forGGe/HappySnail-THSensor/README.rst

############################################################################
Happy Snail TH-Sensor: RS-485 ModBus Digital Temperature and Humidity Sensor
############################################################################
