forGGe/HappySnail-THSensor/proto_II/proto_II_kicad/common/3d/Tactile_Switch_5x5mm.STEP

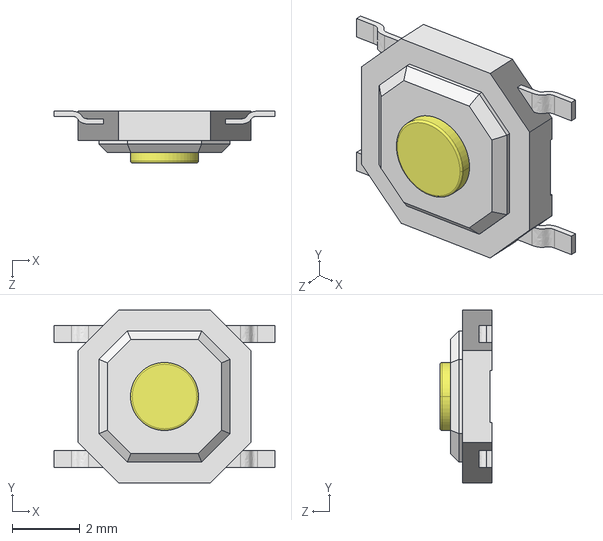
[picture p1: CAD file, 2019-10-02]
proto_II/proto_II_kicad/common/3d/Tactile_Switch_5x5mm.STEP
6.50 x 5.08 x 1.52 mm
