forGGe/HappySnail-THSensor/proto_II/proto_II_kicad/common/3d/Murata_CSTCEXX_3.2mmx1.3mm.stp

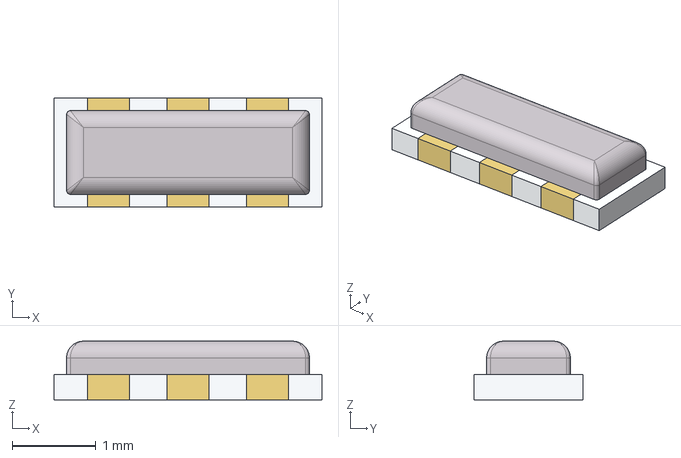
[picture p2: CAD file, 2019-10-02]
proto_II/proto_II_kicad/common/3d/Murata_CSTCEXX_3.2mmx1.3mm.stp
3.20 x 1.30 x 0.7 mm
