forGGe/HappySnail-THSensor/proto_II/proto_II_kicad/common/3d/DG306-5.STEP

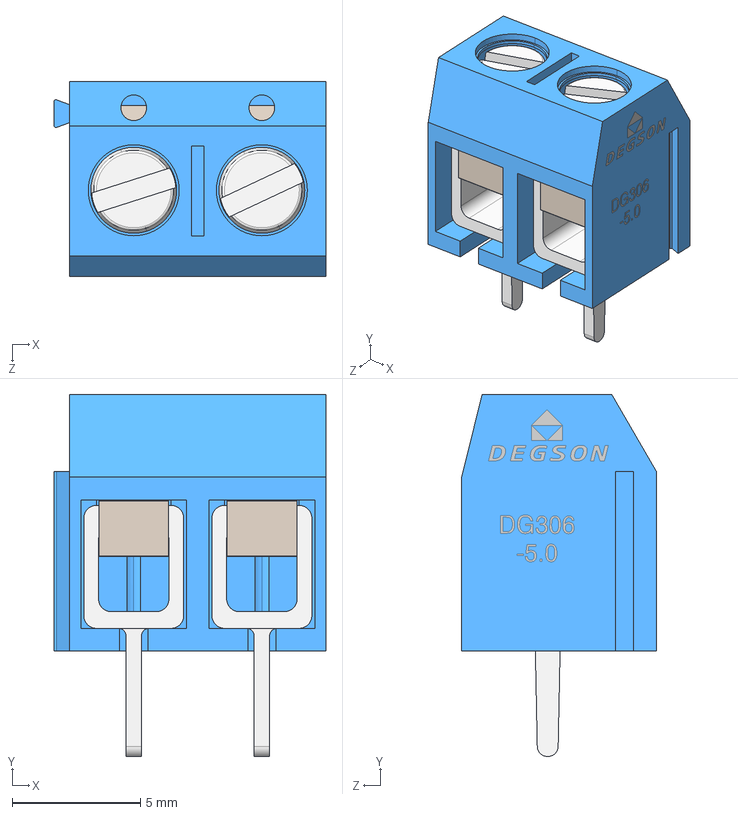
[picture p3: CAD file, 2019-07-09]
proto_II/proto_II_kicad/common/3d/DG306-5.STEP
10.6 x 14.1 x 7.60 mm
Case
Screw x 2
Terminal x 2
Spring x 2
