forGGe/HappySnail-THSensor/proto_II/proto_II_kicad/common/3d/CDRN74.stp

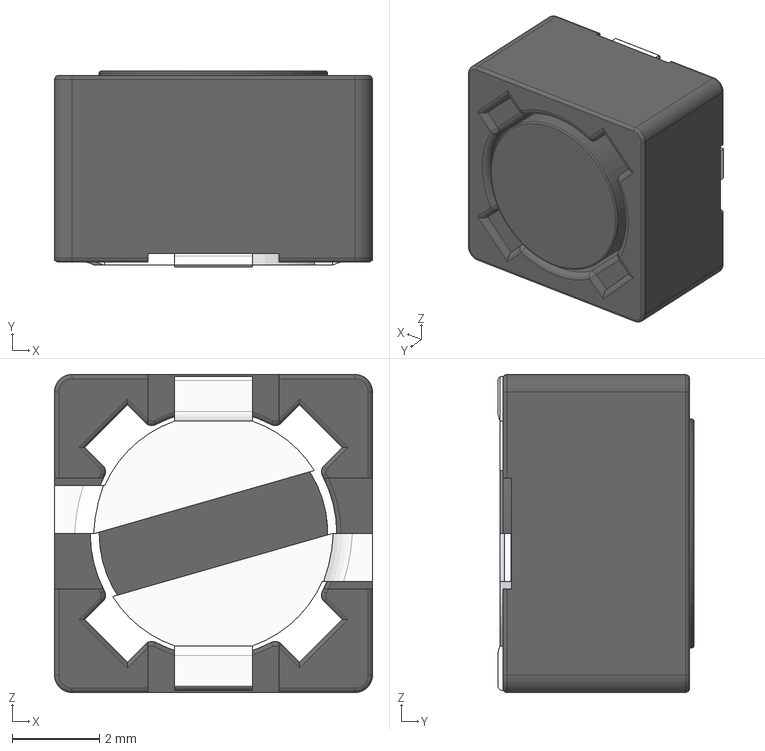
[picture p4: CAD file, 2019-07-09]
proto_II/proto_II_kicad/common/3d/CDRN74.stp
7.30 x 4.50 x 7.30 mm
