forGGe/HappySnail-THSensor/proto_II/proto_II_kicad/common/3d/SF2.STEP

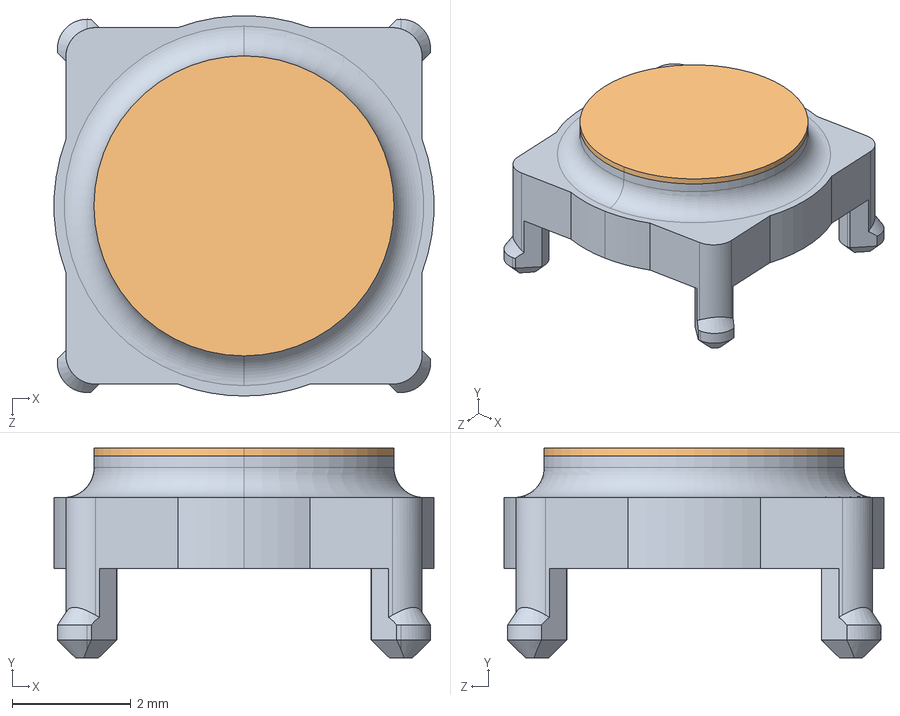
[picture p5: CAD file, 2019-07-07]
proto_II/proto_II_kicad/common/3d/SF2.STEP
6.39 x 3.53 x 6.40 mm
H01-0023_00
H01-0032_00
