forGGe/HappySnail-THSensor/(threads)

Thread 16 (2019-12-26):

Create rev1 for Proto II/Mark I

forGGe, 2019-12-26:
During the testing of Proto II, a number of issues has been found.

Following items must be addressed in rev.1 of the Proto II

- [ ] Check markings near R201 (overlap with via).
- [ ] A and B channels RS485 are swapped (bring it back)
- [ ] Check markings C105
- [ ] R304 and C301 markings should be swapped
- [ ] RX/TX diodes must be reversed, or they should be tied to +3v3 (lid only when in transmit)
- [ ] Reorient doides and resistors to prevent bridges
- [ ] Better way to switch 120 ohm on and off
- [ ] Get rid of 5V-variant network
- [ ] Make test points smaller
- [ ] Add test points for BOOT0/BOOT1, SWDIO/SWCLK/SWGND, DE/~RE
- [ ] Swap UART1 and UART2 - UART1 can be used for flashing a board, better use this as a debug UART
- [ ] No need in two RE/~DE optocouplers - can be used one and split right before ST485
- [ ] Think even further - check ADUMXXX prices with 3 channels instead of 2.
- [ ] Better place connectors, so wires won't overlap with high profile components
- [ ] Use generic components in BOM (0603 LED, etc.) - make sure they match partsbox names
- [ ] Add fiducial
- [ ] Optimize BOM for assembly in jlcpcb

forGGe, 2019-12-26:
> - [x]  Swap UART1 and UART2 - UART1 can be used for flashing a board, better use this as a debug UART

UART2 is not 5V tolerant. Instead, UART3 is used in place of UART1.

So, UART1 will be used for debugging purposes, UART3 will be used for communicating with RS485 transceiver.
