forGGe/HappySnail-THSensor/proto_II/proto_II_kicad/sensor/proto_II_sensor_kicad.kicad_pcb

## KiCad design proto_II/proto_II_kicad/sensor/proto_II_sensor_kicad.kicad_pcb (2019-11-14)

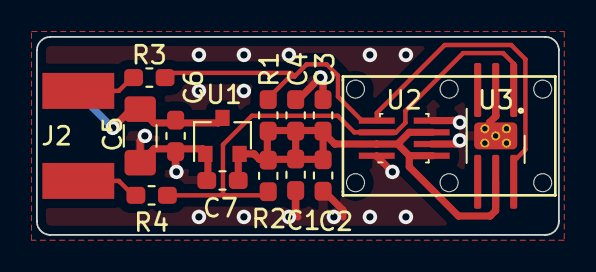
[picture p6: board proto_II_sensor_kicad.kicad_pcb from above]

Board: 2 copper layers, 29.0 x 11.0 mm, 16 parts (1 on the bottom side), 7 nets.

Parts:
C1, C4: 100n; C_0603_1608Metric_Pad1.05x0.95mm_HandSolder
C2, C3: 10n; C_0603_1608Metric_Pad1.05x0.95mm_HandSolder
C5: 10u; C_1206_3216Metric_Pad1.42x1.75mm_HandSolder
C6, C7: 1u; C_0603_1608Metric_Pad1.05x0.95mm_HandSolder
J1, J2: Conn_01x02; PAD_2
R1, R2: 4K7; R_0603_1608Metric_Pad1.05x0.95mm_HandSolder
R3, R4: TERM; R_0603_1608Metric_Pad1.05x0.95mm_HandSolder
U1: XC6206P332MR; SOT-23
U2: BME280; Bosch_LGA-8_2.5x2.5mm_P0.65mm_ClockwisePinNumbering_HandSol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
U3: Si7020-A20; DFN-6-1EP_3x3mm_P1mm_EP1.5x2.4mm_HandSoldering

Connections:
+3V3: C1.1, C2.1, C3.1, C4.1, C7.1, R1.1, R2.1, U1.2, U2.2, U2.6, U2.8, U3.5
+5V: C5.1, C6.1, J1.1, U1.3
/SCL: J2.1, R3.1
/SCL_IC: R1.2, R3.2, U2.4, U3.6
/SDA: J2.2, R4.1
/SDA_IC: R2.2, R4.2, U2.3, U3.1
GND: C1.2, C2.2, C3.2, C4.2, C5.2, C6.2, C7.2, J1.2, U1.1, U2.1, U2.5, U2.7, U3.2, U3.7
