forGGe/HappySnail-THSensor/proto_II/proto_II_kicad/assembly/proto_II_assembly.kicad_pcb

## KiCad design proto_II/proto_II_kicad/assembly/proto_II_assembly.kicad_pcb (2019-11-14)

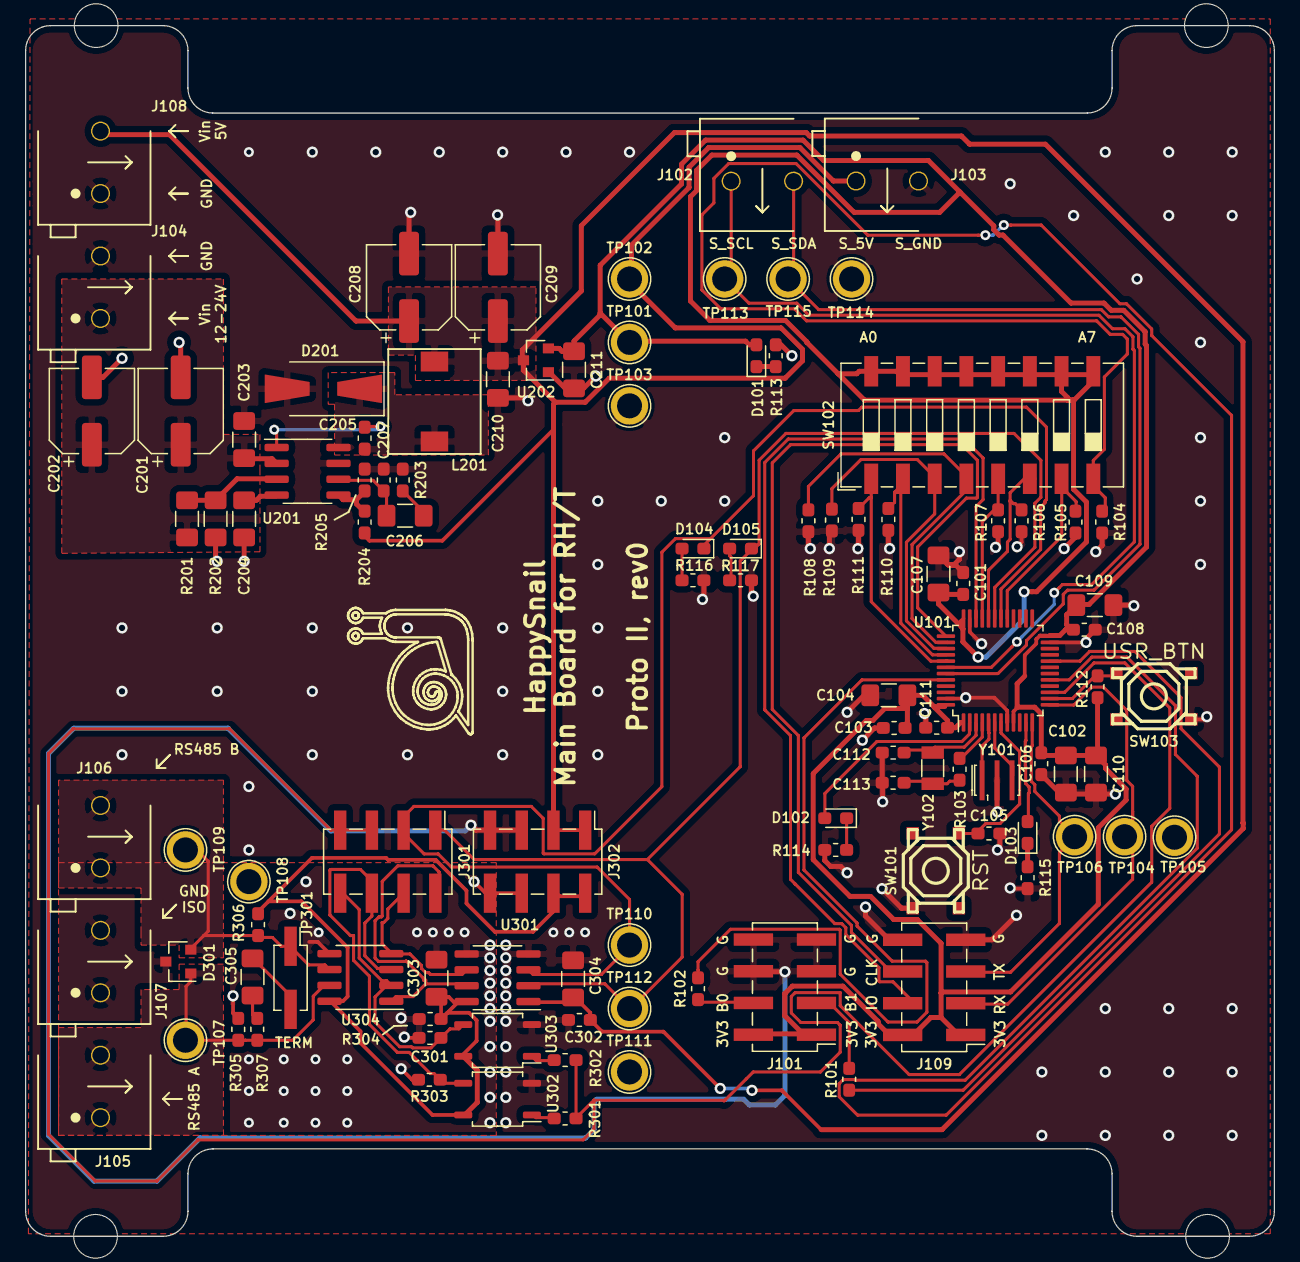
[picture p7: board proto_II_assembly.kicad_pcb from above]

Board: 2 copper layers, 100.0 x 97.0 mm, 105 parts (0 on the bottom side), 58 nets.

Parts:
C101, C103, C105, C106, C108, C111, C205, C301, C302: 100n; C_0603_1608Metric_Pad1.05x0.95mm_HandSolder
C102, C104, C107, C109, C110, C210, C211, C303, C304: 1u; C_1206_3216Metric_Pad1.42x1.75mm_HandSolder
C112, C113, C207: 10p; C_0603_1608Metric_Pad1.05x0.95mm_HandSolder
C201, C202: 10u; CP_Elec_6.3x5.7
C203, C204, C206, C305: 10n; C_1206_3216Metric_Pad1.42x1.75mm_HandSolder
C208, C209: 47u; CP_Elec_6.3x5.7
D101: PWR_LED; D_0603_1608Metric_Pad1.05x0.95mm_HandSolder
D102: USR1_LED; D_0603_1608Metric_Pad1.05x0.95mm_HandSolder
D103: USR2_LED; D_0603_1608Metric_Pad1.05x0.95mm_HandSolder
D104: DI_LED; D_0603_1608Metric_Pad1.05x0.95mm_HandSolder
D105: RO_LED; D_0603_1608Metric_Pad1.05x0.95mm_HandSolder
D201: 700mV; D_SMA-SMB_Universal_Handsoldering
D301: SM712; SOT-23
J101: BOOT_CFG; PinHeader_2x04_P2.54mm_Vertical_SMD
J102: SNSR_I2C; DG300-5.0-02P-12
J103: SNSR_PWR; DG300-5.0-02P-12
J104: Vin; DG300-5.0-02P-12
J105: RS485_A; DG300-5.0-02P-12
J106: RS485_B; DG300-5.0-02P-12
J107: ISO_GND; DG300-5.0-02P-12
J108: Vin-5V; DG300-5.0-02P-12
J109: SWD_DBG; PinHeader_2x04_P2.54mm_Vertical_SMD
J301: SIG_BYPASS; PinHeader_2x04_P2.54mm_Vertical_SMD
J302: PWR_BYPASS; PinHeader_2x04_P2.54mm_Vertical_SMD
JP301: JP; PinHeader_2x01_P2.54mm_Vertical_SMD
L201: 22u; CDRH74
R101, R102, R104, R105, R106, R107, R108, R109, R110, R111, R112, R203, R204, R303, R304: 10K; R_0603_1608Metric_Pad1.05x0.95mm_HandSolder
R103: 0R; R_0603_1608Metric_Pad1.05x0.95mm_HandSolder
R113, R114, R115, R116, R117, R205, R301, R302, R305, R306: 2K2; R_0603_1608Metric_Pad1.05x0.95mm_HandSolder
R201: 220K; R_1206_3216Metric_Pad1.42x1.75mm_HandSolder
R202: 47K; R_1206_3216Metric_Pad1.42x1.75mm_HandSolder
R307: 120; R_0603_1608Metric_Pad1.05x0.95mm_HandSolder
SW101: RST; Tactile_Switch_5x5mm
SW102: MODBUS_ADDR; SW_DIP_SPSTx08_Slide_9.78x22.5mm_W8.61mm_P2.54mm
SW103: USR_BTN; Tactile_Switch_5x5mm
TP101: 3V3; TestPoint_Plated_Hole_D2.0mm
TP102: 5V; TestPoint_Plated_Hole_D2.0mm
TP103: G; TestPoint_Plated_Hole_D2.0mm
TP104: U2_RX; TestPoint_Plated_Hole_D2.0mm
TP105: G_U2; TestPoint_Plated_Hole_D2.0mm
TP106: U2_TX; TestPoint_Plated_Hole_D2.0mm
TP107: A; TestPoint_Plated_Hole_D2.0mm
TP108: G_ISO; TestPoint_Plated_Hole_D2.0mm
TP109: B; TestPoint_Plated_Hole_D2.0mm
TP110: U1_RX; TestPoint_Plated_Hole_D2.0mm
TP111: G_U1; TestPoint_Plated_Hole_D2.0mm
TP112: U1_TX; TestPoint_Plated_Hole_D2.0mm
TP113: SCL; TestPoint_Plated_Hole_D2.0mm
TP114: G_I2C; TestPoint_Plated_Hole_D2.0mm
TP115: SDA; TestPoint_Plated_Hole_D2.0mm
U101: STM32F103C8Tx; LQFP-48_7x7mm_P0.5mm
U201: TPS54331; SOIC-8_3.9x4.9mm_P1.27mm
U202: XC6206P332MR; SOT-23
U301: ADUM5241; SOIC-8_3.9x4.9mm_P1.27mm
U302, U303: EL357N-G; SOP-4_3.8x4.1mm_P2.54mm
U304: ST485EBDR; SOIC-8_3.9x4.9mm_P1.27mm
Y101: HSE; Murata_CSTCE8M0V53-R0-3Pin_3.2x1.1mm_HandSoldering
Y102: LSE; Crystal_SMD_3215-2Pin_3.2x1.5mm

Connections:
+3V3: C101.1, C102.1, C103.1, C104.1, C106.1, C107.1, C108.1, C109.1, C110.1, C111.1, C211.1, D101.2, J101.1, J101.2, J109.1, J109.2, R112.2, SW102.9, SW102.10, SW102.11, SW102.12, SW102.13, SW102.14, SW102.15, SW102.16, TP101.1, U101.1, U101.9, U101.24, U101.36, U101.48, U202.2
+5V: C208.1, C209.1, C210.1, C302.1, C304.1, J103.1, J108.2, J302.1, J302.3, L201.2, R204.1, TP102.1, U202.3, U301.1
+5VD: C301.1, C303.1, J302.2, J302.4, R306.2, U301.8, U302.4, U303.4, U304.8
/BOOT0: R102.2, U101.44
/BOOT1: R101.1, U101.20
/DE~RE: J301.5, J301.7, R301.2, R302.2, U101.15
/I2C1_SCL: J102.1, TP113.1, U101.42
/I2C1_SDA: J102.2, TP115.1, U101.43
/MODBUS_A0: R111.1, SW102.1, U101.41
/MODBUS_A1: R110.1, SW102.2, U101.40
/MODBUS_A2: R109.1, SW102.3, U101.39
/MODBUS_A3: R108.1, SW102.4, U101.38
/MODBUS_A4: R107.1, SW102.5, U101.33
/MODBUS_A5: R106.1, SW102.6, U101.32
/MODBUS_A6: R105.1, SW102.7, U101.29
/MODBUS_A7: R104.1, SW102.8, U101.17
/NRST: C105.1, SW101.2, U101.7
/OSC32_IN: C112.1, U101.3, Y102.1
/OSC32_OUT: R103.1, U101.4
/OSC_IN: U101.5, Y101.1
/OSC_OUT: U101.6, Y101.3
/RS485_A: D301.1, J105.1, J105.2, R305.2, R307.2, TP107.1, U304.7
/RS485_B: D301.2, J106.1, J106.2, JP301.1, R306.1, TP109.1, U304.6
/SWDCLK: J109.6, U101.37
/SWDIO: J109.4, U101.34
/UART1_RX: D105.1, J301.1, TP112.1, U101.31, U301.2
/UART1_TX: D104.1, J301.3, TP110.1, U101.30, U301.3
/UART2_RX: J109.3, TP104.1, U101.13
/UART2_TX: J109.5, TP106.1, U101.12
/USR1_LED: D102.2, U101.2
/USR2_LED: D103.2, U101.11
/USR_BTN: R112.1, SW103.2, U101.14
/power/PH: C205.1, D201.1, L201.1, U201.8
/power/Vin: C201.1, C202.1, C203.1, J104.1, R201.1, U201.2
/rs485/DE_XMTR: J301.6, R303.2, U302.3, U304.3
/rs485/DI_XMTR: J301.4, U301.6, U304.4
/rs485/RE_XMTR: J301.8, R304.2, U303.3, U304.2
/rs485/RO_XMTR: J301.2, U301.7, U304.1
GND: C101.2, C102.2, C103.2, C104.2, C105.2, C106.2, C107.2, C108.2, C109.2, C110.2, C111.2, C112.2, C113.1, C201.2, C202.2, C203.2, C204.2, C207.2, C208.2, C209.2, C210.2, C211.2, C302.2, C304.2, D201.2, J101.5, J101.6, J101.7, J101.8, J103.2, J104.2, J108.1, J109.7, J109.8, J302.5, J302.7, R104.2, R105.2, R106.2, R107.2, R108.2, R109.2, R110.2, R111.2, R113.2, R114.2, R115.2, R116.2, R117.2, R202.2, R203.2, R205.2, SW101.1, SW103.1, TP103.1, TP105.1, TP111.1, TP114.1, U101.8, U101.23, U101.35, U101.47, U201.7, U202.1, U301.4, U302.2, U303.2, Y101.2
GNDD: C301.2, C303.2, D301.3, J107.1, J107.2, J302.6, J302.8, R303.1, R304.1, R305.1, TP108.1, U301.5, U304.5
unnamed: C113.2, R103.2, Y102.2
unnamed: C204.1, U201.4
unnamed: C205.2, U201.1
unnamed: C206.1, C207.1, U201.6
unnamed: C206.2, R203.1
unnamed: C305.1, R307.1
unnamed: C305.2, JP301.2
unnamed: D101.1, R113.1
unnamed: D102.1, R114.1
unnamed: D103.1, R115.1
unnamed: D104.2, R116.1
unnamed: D105.2, R117.1
unnamed: J101.3, R101.2
unnamed: J101.4, R102.1
unnamed: R201.2, R202.1, U201.3
unnamed: R204.2, R205.1, U201.5
unnamed: R301.1, U302.1
unnamed: R302.1, U303.1
