forGGe/HappySnail-THSensor/proto_II/proto_II_kicad/sensor_small/proto_II_sensor_small_kicad.kicad_pcb

## KiCad design proto_II/proto_II_kicad/sensor_small/proto_II_sensor_small_kicad.kicad_pcb (2019-09-16)

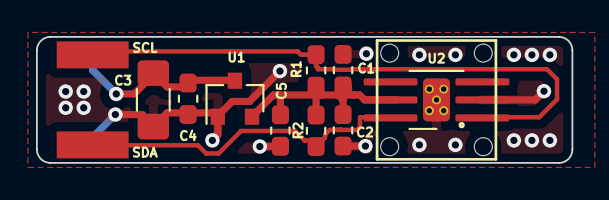
[picture p8: board proto_II_sensor_small_kicad.kicad_pcb from above]

Board: 2 copper layers, 29.8 x 7.0 mm, 11 parts (1 on the bottom side), 5 nets.

Parts:
C1: 100n; C_0603_1608Metric_Pad1.05x0.95mm_HandSolder
C2: 10n; C_0603_1608Metric_Pad1.05x0.95mm_HandSolder
C3: 10u; C_1206_3216Metric_Pad1.42x1.75mm_HandSolder
C4, C5: 1u; C_0603_1608Metric_Pad1.05x0.95mm_HandSolder
J1: PWR_CONN; PAD_2_small
J2: I2C_CONN; PAD_2_small
R1, R2: 4K7; R_0603_1608Metric_Pad1.05x0.95mm_HandSolder
U1: XC6206P332MR; SOT-23
U2: Si7020-A20; DFN-6-1EP_3x3mm_P1mm_EP1.5x2.4mm_HandSoldering

Connections:
+3V3: C1.1, C2.1, C5.1, R1.1, R2.1, U1.2, U2.5
+5V: C3.1, C4.1, J1.1, U1.3
/SCL: J2.1, R1.2, U2.1
/SDA: J2.2, R2.2, U2.6
GND: C1.2, C2.2, C3.2, C4.2, C5.2, J1.2, U1.1, U2.2, U2.7
