forGGe/HappySnail-THSensor/proto_II/proto_II_kicad/buck/proto_II_buck_kicad.kicad_pcb

## KiCad design proto_II/proto_II_kicad/buck/proto_II_buck_kicad.kicad_pcb (2019-08-08)

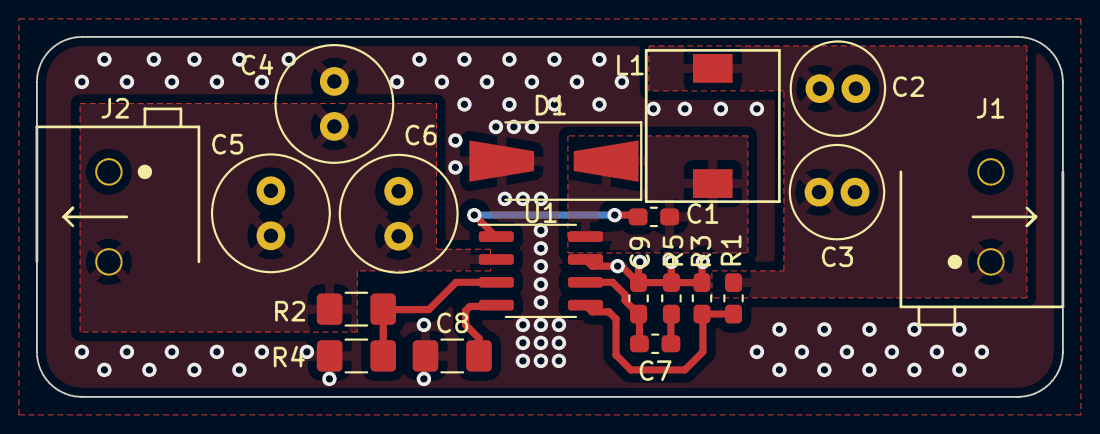
[picture p9: board proto_II_buck_kicad.kicad_pcb from above]

Board: 2 copper layers, 57.0 x 20.0 mm, 19 parts (0 on the bottom side), 10 nets.

Parts:
C1: 100n; C_0603_1608Metric_Pad1.05x0.95mm_HandSolder
C2, C3: 47u; C_Radial_D5.0mm_H11.0mm_P2.00mm
C4, C5: 10u; C_Radial_D6.3mm_H11.0mm_P2.50mm
C6: 10n; C_Radial_D6.3mm_H11.0mm_P2.50mm
C7: 2n2; C_0603_1608Metric_Pad1.05x0.95mm_HandSolder
C8: 10n; C_1206_3216Metric_Pad1.42x1.75mm_HandSolder
C9: 10p; C_0603_1608Metric_Pad1.05x0.95mm_HandSolder
D1: 700mV; D_SMA-SMB_Universal_Handsoldering
J1: VDC_OUT; DG300-5.0-02P-12
J2: VDC_IN; DG300-5.0-02P-12
L1: 22u; CDRH74
R1: 10K; R_0603_1608Metric_Pad1.05x0.95mm_HandSolder
R2: 220K; R_1206_3216Metric_Pad1.42x1.75mm_HandSolder
R3: 2K2; R_0603_1608Metric_Pad1.05x0.95mm_HandSolder
R4: 47K; R_1206_3216Metric_Pad1.42x1.75mm_HandSolder
R5: 13K3; R_0603_1608Metric_Pad1.05x0.95mm_HandSolder
U1: TPS54331; SOIC-8_3.9x4.9mm_P1.27mm

Connections:
/PH: C1.1, D1.1, L1.1, U1.8
/VIN: C4.1, C5.1, C6.1, J2.2, R2.1, U1.2
/VOUT: C2.1, C3.1, J1.1, L1.2, R1.1
GND: C2.2, C3.2, C4.2, C5.2, C6.2, C8.2, C9.2, D1.2, J1.2, J2.1, R3.2, R4.2, R5.2, U1.7
unnamed: C1.2, U1.1
unnamed: C7.1, C9.1, U1.6
unnamed: C7.2, R5.1
unnamed: C8.1, U1.4
unnamed: R1.2, R3.1, U1.5
unnamed: R2.2, R4.1, U1.3
