forGGe/HappySnail-THSensor/proto_II/proto_II_kicad/rs485/proto_II_rs485.kicad_pcb

## KiCad design proto_II/proto_II_kicad/rs485/proto_II_rs485.kicad_pcb (2019-07-18)

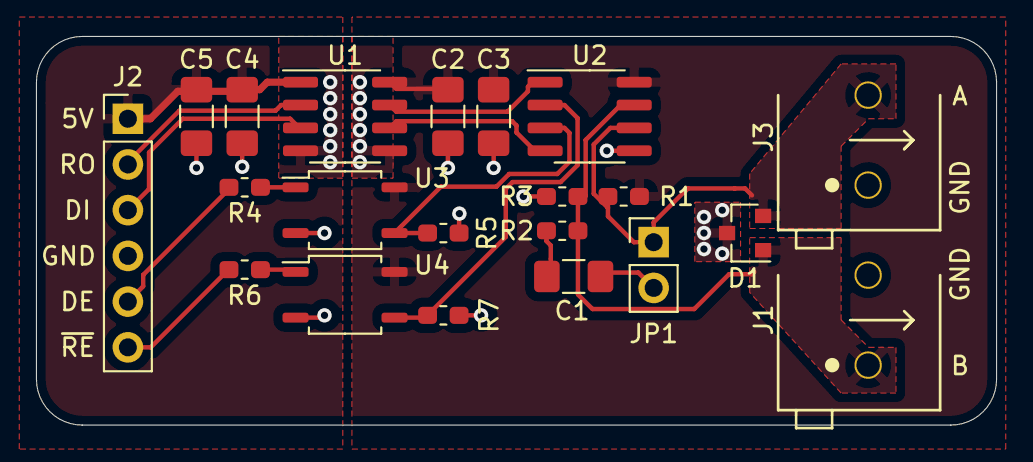
[picture p10: board proto_II_rs485.kicad_pcb from above]

Board: 2 copper layers, 53.3 x 21.6 mm, 21 parts (0 on the bottom side), 18 nets.

Parts:
C1: 10n; C_1206_3216Metric_Pad1.42x1.75mm_HandSolder
C2, C4: 100n; C_1206_3216Metric_Pad1.42x1.75mm_HandSolder
C3, C5: 1u; C_1206_3216Metric_Pad1.42x1.75mm_HandSolder
D1: SM712; SOT-23
J1: A_CONN; DG300-5.0-02P-12
J2: INPUT; PinHeader_1x06_P2.54mm_Vertical
J3: B_CONN; DG300-5.0-02P-12
JP1: JP; PinHeader_1x02_P2.54mm_Vertical
R1, R3, R4, R6: 2K2; R_0603_1608Metric_Pad1.05x0.95mm_HandSolder
R2: 120; R_0603_1608Metric_Pad1.05x0.95mm_HandSolder
R5, R7: 10K; R_0603_1608Metric_Pad1.05x0.95mm_HandSolder
U1: ADUM5241; SOIC-8_3.9x4.9mm_P1.27mm
U2: ST485EBDR; SOIC-8_3.9x4.9mm_P1.27mm
U3, U4: EL357N-G; SOP-4_3.8x4.1mm_P2.54mm

Connections:
+5V: C4.1, C5.1, J2.1, U1.1
+5VD: C2.1, C3.1, R1.2, U1.8, U2.8, U3.4, U4.4
/A: D1.2, J3.2, JP1.1, R1.1, U2.6
/B: D1.1, J1.1, R2.2, R3.2, U2.7
/DE: J2.5, R4.2
/DI: J2.3, U1.3
/RO: J2.2, U1.2
/~RE: J2.6, R6.2
GND: C4.2, C5.2, J2.4, U1.4, U3.2, U4.2
GNDD: C2.2, C3.2, D1.3, J1.2, J3.1, R3.1, R5.1, R7.1, U1.5, U2.5
unnamed: C1.1, R2.1
unnamed: C1.2, JP1.2
unnamed: R4.1, U3.1
unnamed: R5.2, U2.3, U3.3
unnamed: R6.1, U4.1
unnamed: R7.2, U2.2, U4.3
unnamed: U1.6, U2.4
unnamed: U1.7, U2.1
