forGGe/HappySnail-THSensor/proto_II/proto_II_zephyr/src/main.c

/*
 * Copyright (c) 2012-2014 Wind River Systems, Inc.
 *
 * SPDX-License-Identifier: Apache-2.0
 */

#include <zephyr.h>
#include <device.h>
#include <sensor.h>
#include <stdio.h>
#include <gpio.h>
#include <misc/printk.h>
#include <assert.h>
#include <uart.h>
#include <string.h>
#include <sys/types.h>
#include <stdlib.h>
#include <i2c.h>
#include <logging/log.h>
#include <stm32f1xx_ll_adc.h>
#include <stm32f1xx_ll_rcc.h>
#include <stm32f1xx_ll_bus.h>

#define MODBUS_BAT_SLAVE_ADDRESS 		42

/* Test registers, used in this BAT */
enum modbus_regs
{
	MODBUS_BAT_INPUT_REG_FIRST		= 1000,
	MODBUS_BAT_INPUT_REG_TEMP_HIGH		= MODBUS_BAT_INPUT_REG_FIRST,
	MODBUS_BAT_INPUT_REG_TEMP_LOW,
	MODBUS_BAT_INPUT_REG_HUMID_HIGH,
	MODBUS_BAT_INPUT_REG_HUMID_LOW,
	MODBUS_BAT_INPUT_REG_PRESSURE_HIGH,
	MODBUS_BAT_INPUT_REG_PRESSURE_LOW,
	MODBUS_BAT_INPUT_REG_LAST		= MODBUS_BAT_INPUT_REG_PRESSURE_LOW,
};

/* Test functions, used in this BAT */
enum modbus_fn
{
/* Not supported (yet)
	MODBUS_FN_READ_COIL			= 0x1,
	MODBUS_FN_READ_INPUT_STATUS		= 0x2,
	MODBUS_FN_READ_INPUT_REG		= 0x4,
*/
	MODBUS_FN_READ_HOLDING_REG		= 0x3,
};

enum modbus_states
{
	MODBUS_EMPTY,
	MODBUS_WAIT_CR,
	MODBUS_WAIT_LF,
	MODBUS_COMPLETE,
};

struct modbus_frame
{
	u8_t data[256];
	u8_t cnt;
	enum modbus_states state;
};

struct modbus_data
{
	u8_t addr;
	u8_t fn;
	uint16_t obj_addr;
	uint16_t qty;
	u8_t crc;
	bool complete;
};

static uint32_t hexchunk_toul(const char *start, size_t qty)
{
	char buf[qty + 1];
	memcpy(buf, start, qty);
	buf[qty] = 0;

	return strtol(buf, NULL, 16);
}

/* TODO: ugly */
static u8_t modbus_lrc(const u8_t *data, size_t sz)
{
	u8_t lrc = 0;

	for (size_t i = 0; i < sz; i += 2) {
		lrc += hexchunk_toul(&data[i], 2);
	}

	return (u8_t)(-lrc);
}

static int modbus_process_raw_frame(struct modbus_frame *buf, struct modbus_data *out)
{
	assert(out != NULL);
	assert(buf != NULL);

	if (buf->cnt != 14) {
		printf("frames with length %d are not supported yet\n", buf->cnt);
		return -1;
	}

	u8_t crc;
	u8_t calc_crc;

	/* TODO: better error check */

	out->addr 	= hexchunk_toul(&buf->data[0], 2);
	out->fn 	= hexchunk_toul(&buf->data[2], 2);
	out->obj_addr 	= hexchunk_toul(&buf->data[4], 4);
	out->qty 	= hexchunk_toul(&buf->data[8], 4);
	crc 		= hexchunk_toul(&buf->data[12], 2);

	if (out->addr != 42) {
		printf("not supported slave address %d\n", out->addr);
		return -1;
	}

	if (out->obj_addr != MODBUS_BAT_INPUT_REG_FIRST) {
		printf("reading regs starting from %d is not implemented\n", out->obj_addr);
		return -1;
	}

	if (out->qty != (MODBUS_BAT_INPUT_REG_LAST - MODBUS_BAT_INPUT_REG_FIRST + 1)) {
		printf("reading regs of range: %d not implmented\n", out->qty);
		return -1;
	}

	/* Exclude crc byte at the end of the packet */
	calc_crc = modbus_lrc(buf->data, buf->cnt - 2);

	if (calc_crc != crc) {
		printf("crc failed. expect: %#x, actual: %#x\n", calc_crc, crc);
	}

	return 0;
}

/**
 * \return Number of bytes processed.
 * \retval 0 Parsing already complete.
 * \retval -1 Invalid frame detected.
 */
static ssize_t modbus_process_raw_data(struct modbus_frame *buf, struct modbus_data *out, const u8_t *new_data, size_t new_data_sz)
{
	assert(buf != NULL);
	assert(out != NULL);
	assert(new_data != NULL);

	printf("buf state: %d %d\n", buf->cnt, buf->state);

	size_t bytes_processed = 0;
	for (; bytes_processed < new_data_sz; ++bytes_processed) {
		u8_t data_byte = new_data[bytes_processed];

		/* Check that buffer is in valid state */
		if (buf->cnt == sizeof(buf->data) - 1) {
			printf("overflow detected\n");
			buf->cnt = 0;
			buf->state = MODBUS_EMPTY;
			continue;
		}

		/* Detect frame start; if detected - should re-init parser at any state */
		if (data_byte == ':') {
			printf("frame start detected\n");
			buf->state = MODBUS_WAIT_CR;
			buf->cnt = 0;
			out->complete = false;
			continue;
		}

		switch (buf->state) {
		case MODBUS_EMPTY:
			printf("skipping data, not yet found a frame start\n");
			break;
		case MODBUS_WAIT_CR:
			/* Check allowed set of symbols */
			if ((data_byte < '0' || data_byte > '9')
					&& (data_byte < 'A' || data_byte > 'F')
					&& data_byte != '\r') {
				printf("invalid symbol detected\n");
				buf->state = MODBUS_EMPTY;
				buf->cnt = 0;
				continue;
			}

			if (data_byte == '\r') {
				printf("CR detected\n");
				buf->state = MODBUS_WAIT_LF;
				continue;
			}

			/* Only state where appending symbols is allowed */
			buf->data[buf->cnt++] = data_byte;
			break;
		case MODBUS_WAIT_LF:
			if (data_byte == '\n') {
				printf("LF detected\n");
				buf->state = MODBUS_COMPLETE;
				printf("data recv: %*s\n", buf->cnt, buf->data);

				if (modbus_process_raw_frame(buf, out) < 0) {
					/* Parsing failed, but invalid and old data can be discarded */
					buf->cnt = 0;
					return -1;
				}

				/* Parsing complete */
				buf->cnt = 0;
				out->complete = true;
				return bytes_processed;
			} else {
				printf("invalid symbol detected while waiting for LF\n");
				buf->state = MODBUS_EMPTY;
				buf->cnt = 0;
			}
			continue;
		case MODBUS_COMPLETE:
			printf("complete frame, no more symbols required\n");
			continue;
			break;
		default:
			printf("invalid state: %d\n", buf->state);
			continue;
			break;
		}
	}

	/* Need more data */
	return bytes_processed;
}

struct drv_ctx
{
	struct device *dev;
	struct device *gpio_dev;
	struct drv_buf {
		u8_t data[256];
		u8_t cnt;
	} buf;
	struct drv_tx_buf {
		u8_t buf[256];
		size_t sz;
		size_t cur;
	} tx_buf;
};

static void uart1_irq_cb(void *user_data)
{
	struct drv_ctx *ctx = user_data;

	uart_irq_update(ctx->dev);

	if (uart_irq_rx_ready(ctx->dev)) {
		int read = uart_fifo_read(ctx->dev, ctx->buf.data + ctx->buf.cnt,
			ARRAY_SIZE(ctx->buf.data) - ctx->buf.cnt);
		ctx->buf.cnt += read;
	}

	/* Check for End-of-TX */
	if (ctx->tx_buf.cur == ctx->tx_buf.sz) {
		ctx->tx_buf.cur = 0;
		ctx->tx_buf.sz = 0;
		uart_irq_tx_disable(ctx->dev);
		/* Enable RS485 RX line and disable TX */
		gpio_pin_write(ctx->gpio_dev, 5, 0);
	}

	if (uart_irq_tx_ready(ctx->dev)
			&& ctx->tx_buf.sz != 0
			&& ctx->tx_buf.cur < ctx->tx_buf.sz) {
		int written = uart_fifo_fill(ctx->dev, &ctx->tx_buf.buf[ctx->tx_buf.cur], 1);
		ctx->tx_buf.cur += written;
	}
}

static struct drv_ctx modbus_ctx;
static struct drv_buf modbus_safe_data;

static int hs_adc_configure(void)
{
	LL_APB2_GRP1_EnableClock(LL_APB2_GRP1_PERIPH_ADC1);
	LL_RCC_SetADCClockSource(LL_RCC_ADC_CLKSRC_PCLK2_DIV_4);

	printf("starting ADC\n");

	LL_ADC_Enable(				ADC1);

	/*
	 * Wait until ADC is completely ready.
	 * TODO: find out precise value of tSTAB for ADC stabilization. See datasheet.
	 */
	k_sleep(100);

	LL_ADC_StartCalibration(		ADC1);
	while (LL_ADC_IsCalibrationOnGoing(	ADC1) == 1) { };

	printf("ADC calibration complete\n");

	/* Enable temperature sensor and voltage ref sampling */
	LL_ADC_SetCommonPathInternalCh(__LL_ADC_COMMON_INSTANCE(ADC1),
			LL_ADC_PATH_INTERNAL_VREFINT | LL_ADC_PATH_INTERNAL_TEMPSENSOR);

	LL_ADC_SetDataAlignment(		ADC1, LL_ADC_DATA_ALIGN_RIGHT);
	LL_ADC_SetSequencersScanMode(		ADC1, LL_ADC_SEQ_SCAN_DISABLE);
	LL_ADC_REG_SetTriggerSource(		ADC1, LL_ADC_REG_TRIG_SOFTWARE);
	LL_ADC_REG_SetSequencerLength(		ADC1, LL_ADC_REG_SEQ_SCAN_DISABLE);
	LL_ADC_REG_SetSequencerDiscont(		ADC1, LL_ADC_REG_SEQ_DISCONT_DISABLE);
	LL_ADC_REG_SetSequencerRanks(		ADC1, LL_ADC_REG_RANK_1, LL_ADC_CHANNEL_TEMPSENSOR);
	LL_ADC_REG_SetContinuousMode(		ADC1, LL_ADC_REG_CONV_SINGLE);
	LL_ADC_REG_SetDMATransfer(		ADC1, LL_ADC_REG_DMA_TRANSFER_NONE);

	/* TODO: tune this value? */
	LL_ADC_SetChannelSamplingTime(		ADC1, LL_ADC_CHANNEL_TEMPSENSOR, LL_ADC_SAMPLINGTIME_239CYCLES_5);

	LL_ADC_SetAnalogWDMonitChannels(	ADC1, LL_ADC_AWD_DISABLE);

	/* Start spare conversion. For some reason, it helps with incorrect MCU temp sensor readings at the beginning */
	LL_ADC_Enable(				ADC1);

	return 0;
}

static int hs_adc_read_mcu_temp(u32_t *mcu_temp)
{
	printf("getting ADC data from internal sensor\n");

	LL_ADC_REG_StartConversionSWStart(ADC1);

	while (LL_ADC_IsActiveFlag_EOS(ADC1) == 0) {
		k_sleep(1000);
	};

	u32_t data = LL_ADC_REG_ReadConversionData12(ADC1);

	/* Temperature sensor voltage at 25C, from datasheet, in mV */
	const u32_t v25 = 1430;
	/* Average slope, from datasheet, uV per C */
	const u32_t avg_slope = 4300;

	/* Temperature sensor readings, in mV. Note Vref = 3300 mV */
	u32_t v_sense = 3300 * data / 4096;

	/*
	 * Final temperature value. Note scaling (V25 - Vsense) from mV to uV
	 * Divident in uV, divisor in uV/C, thus resulting value is in C.
	 */
	u32_t temp = (1000 * (v25 - v_sense) / avg_slope) + 25;

	printf("adc data: %#x, mV: %d, temp: %d\n", data, v_sense, temp);

	*mcu_temp = temp;
	return 0;
}

void main(void)
{
	struct device *sensor_dev = device_get_binding("SENSOR_CHIP");
	struct device *rs485_dev = device_get_binding("UART_1");
	struct device *gpioa = device_get_binding("GPIOA");

	modbus_ctx.dev = rs485_dev;
	modbus_ctx.gpio_dev = gpioa;

	int rc;

	printf("Hello World! %s\n", CONFIG_BOARD);
	printf("Starting BAT test for Happy Snail RH/T subproject\n");

	if (sensor_dev == NULL) {
		printf("could not get SI7006 device\n");
		return;
	}

	if (gpioa == NULL) {
		printf("could not get GPIOA device\n");
		return;
	}

	if (rs485_dev == NULL) {
		printf("could not get RS485 device\n");
		return;
	}

	printf("sensor_dev %p name %s\n", sensor_dev, sensor_dev->config->name);

	/* Enable internal ADC for getting MCU temp */

	rc = hs_adc_configure();
	if (rc < 0) {
		printf("failed to configure ADC");
	}

	/* Enable RS485 and configure UART */

	rc = gpio_pin_configure(gpioa, 5, GPIO_DIR_OUT);
	if (rc < 0) {
		printf("failed to configure GPIO pin\n");
	}

	struct uart_config uart1_cfg = {
		.baudrate	= 9600,
		.parity		= UART_CFG_PARITY_NONE,
		.stop_bits	= UART_CFG_STOP_BITS_1,
		.data_bits	= UART_CFG_DATA_BITS_8,
		.flow_ctrl	= UART_CFG_FLOW_CTRL_NONE
	};

	rc = uart_configure(rs485_dev, &uart1_cfg);
	if (rc < 0) {
		printf("failed to configure uart1: %d\n", rc);
		goto err;
	}

	uart_irq_callback_user_data_set(rs485_dev, uart1_irq_cb, &modbus_ctx);

	uart_irq_rx_enable(rs485_dev);

	struct modbus_frame frame = {0};
	struct modbus_data modbus_parsed = {0};

	/* Enable RS485 RX line and disable TX */
	gpio_pin_write(gpioa, 5, 0);

	while (1) {
		k_cpu_idle();

		irq_disable(DT_USART_1_IRQ);
		memcpy(&modbus_safe_data, &modbus_ctx.buf, sizeof(modbus_safe_data));
		modbus_ctx.buf.cnt = 0;
		irq_enable(DT_USART_1_IRQ);

		if (modbus_safe_data.cnt > 0) {
			printf("> data %d: %*s\n", (int)modbus_safe_data.cnt, modbus_safe_data.cnt, modbus_safe_data.data);
			size_t read = modbus_process_raw_data(&frame, &modbus_parsed, modbus_safe_data.data, modbus_safe_data.cnt);
			printf("> modbus processed: %d\n", read);
			if (modbus_parsed.complete) {
				struct sensor_value temp = {0};
				struct sensor_value humidity = {0};
				u32_t mcu_temp;

				sensor_sample_fetch(sensor_dev);
				sensor_channel_get(sensor_dev, SENSOR_CHAN_AMBIENT_TEMP, &temp);
				sensor_channel_get(sensor_dev, SENSOR_CHAN_HUMIDITY, &humidity);
				hs_adc_read_mcu_temp(&mcu_temp);

				printf("temp: %d.%06d; mcu_temp: %d; humidity: %d.%06d\n",
					temp.val1, temp.val2,
					mcu_temp,
					humidity.val1, humidity.val2);

				bool retry = true;
				do {
					irq_disable(DT_USART_1_IRQ);
					if (modbus_ctx.tx_buf.sz == 0) {
						/* TODO: ugly */
						int n = snprintf(modbus_ctx.tx_buf.buf, sizeof(modbus_ctx.tx_buf.buf),
							":%02X%02X%02X%04X%04X%04X%04X%04X%04X",
							MODBUS_BAT_SLAVE_ADDRESS, MODBUS_FN_READ_HOLDING_REG,
							12, /* Total bytes to be transmitted */
							(s16_t)temp.val1, 	(s16_t)(temp.val2 / 10000), /* Convert 10^-6 fixed-point value to 10^-2 */
							(s16_t)mcu_temp,	(s16_t)(0), /* Convert 10^-6 fixed-point value to 10^-2 */
							(s16_t)humidity.val1,	(s16_t)(humidity.val2 / 10000) /* Convert 10^-6 fixed-point value to 10^-2 */
						);

						/* TODO: ugly */

						u8_t crc = modbus_lrc(modbus_ctx.tx_buf.buf + 1, n - 1);
						n += snprintf(modbus_ctx.tx_buf.buf + n, sizeof(modbus_ctx.tx_buf.buf) - n,
							"%02X\r\n", crc);
						modbus_ctx.tx_buf.sz = n;
						printf("> sending: %*s\n", modbus_ctx.tx_buf.sz, modbus_ctx.tx_buf.buf);
						retry = false;
					}

					irq_enable(DT_USART_1_IRQ);
					k_sleep(100);
				} while (retry);

				/* Enable RX line and disable TX */
				gpio_pin_write(gpioa, 5, 1);

				/* Rest of processing will occur in ISR routine */
				uart_irq_tx_enable(rs485_dev);

				retry = true;
				do {
					irq_disable(DT_USART_1_IRQ);
					retry = (modbus_ctx.tx_buf.sz != 0);
					irq_enable(DT_USART_1_IRQ);
					k_sleep(100);
				} while (retry);

				printf("response sent\n");
				/* Done with sending this response, try next one */
				modbus_parsed.complete = false;
			}

			modbus_safe_data.cnt -= read;
		}
	}

	return;
err:
	printf("failed to run BAT\n");
}
