forGGe/HappySnail-THSensor/proto_I/.attic/common/arduino/modbus/ModbusSerial.h

/*
    ModbusSerial.h - Header for ModbusSerial Library
    Copyright (C) 2014 Andr� Sarmento Barbosa
*/
#include <Arduino.h>
#include "Modbus.h"

#ifndef MODBUSSERIAL_H
#define MODBUSSERIAL_H

//#define USE_SOFTWARE_SERIAL

#ifdef USE_SOFTWARE_SERIAL
#include <SoftwareSerial.h>
#endif

class ModbusSerial : public Modbus {
    private:
        Stream* _port;
        long  _baud;
        u_int _format;
        int   _txPin;
        unsigned int _t15; // inter character time out
        unsigned int _t35; // frame delay
        byte  _slaveId;
        word calcCrc(byte address, byte* pduframe, byte pdulen);
    public:
        ModbusSerial();
        bool setSlaveId(byte slaveId);
        byte getSlaveId();
        bool config(HardwareSerial* port, long baud, u_int format, int txPin=-1);
        #ifdef USE_SOFTWARE_SERIAL
        bool config(SoftwareSerial* port, long baud, int txPin=-1);
        #endif
        #ifdef __AVR_ATmega32U4__
        bool config(Serial_* port, long baud, u_int format, int txPin=-1);
        #endif
        void task();
        bool receive(byte* frame);
        bool sendPDU(byte* pduframe);
        bool send(byte* frame);
};

/* Table of CRC values for high�order byte */
const byte _auchCRCHi[] = {
    0x00, 0xC1, 0x81, 0x40, 0x01, 0xC0, 0x80, 0x41, 0x01, 0xC0, 0x80, 0x41, 0x00, 0xC1, 0x81,
	0x40, 0x01, 0xC0, 0x80, 0x41, 0x00, 0xC1, 0x81, 0x40, 0x00, 0xC1, 0x81, 0x40, 0x01, 0xC0,
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
	0x48, 0x49, 0x89, 0x4B, 0x8B, 0x8A, 0x4A, 0x4E, 0x8E, 0x8F, 0x4F, 0x8D, 0x4D, 0x4C, 0x8C,
	0x44, 0x84, 0x85, 0x45, 0x87, 0x47, 0x46, 0x86, 0x82, 0x42, 0x43, 0x83, 0x41, 0x81, 0x80,
	0x40};

#endif //MODBUSSERIAL_H
