forGGe/HappySnail-THSensor/(commit log)

2019-06-16 Add prototype I subproject tree and basic schematic
    [proto_I_kicad.kicad_pcb, proto_I_kicad.sch]
2019-06-16 RS485 reading and writing
    [proto_I_kicad.sch]
2019-06-19 Zephyr-based BAT placeholder
    Previous stuff moved to .attic
    [proto_I_kicad.sch]
2019-06-23 Complete BAT schematics
    [proto_I_kicad.sch]
2019-06-30 Proto II: basic circuit around TPS54331, not computed yet
    Values of components to be computed later.
    [file5D1E3AAE.sch, proto_II_kicad.kicad_pcb, proto_II_kicad.sch]
2019-07-02 Re-wire switching power supply and add sensor sub-project
    Switching regulator re-wired according to guidelines.
    Still, freq compensation values must be re-calculated.
    Sensor sub-project is added. Its purpose to deliver small PCB
    board, where sensor is soldered and sealed.
    [buck_subpcb.sch, file5D1E3AAE.sch, proto_II_kicad.sch, proto_II_sensor_kicad.sch]
2019-07-07 Proto II: route for sensor board
    Add libraries and footprints for SF2 cap and simple PAD connector for
    soldering wires
    [SF2.STEP, proto_II_kicad.sch, proto_II_sensor_kicad.sch]
2019-07-09 Proto II: route buck converter sub-board
    Additionally:
    - Made footprint for inductor and found 3d-model for that
    - Add missing PCB and netlist for sensor sub-board (see previous commit)
    - Couple of addtions for existing footprints (SF2, PAD, etc.)A
    - Update gitignore to ignore cache KiCAD files
    [CDRN74.stp, DG306-5.STEP, proto_II_buck_kicad.kicad_pcb, proto_II_buck_kicad.sch, proto_II_sensor_kicad.kicad_pcb]
2019-07-09 Proto II: panelized sensor and buck board, order from JLCPCB
    + gerber files
    [buck_subpcb.sch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]
2019-07-12 Proto II: cleanup and move project to separate dirs
    Common library is substituted. Gerber files are updated to match what
    sent to JLCPCB
    [CDRN74.stp, DG306-5.STEP, SF2.STEP, buck_subpcb.sch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]
2019-07-17 Proto II: RS485 isolated module board
    [proto_II_rs485.kicad_pcb, proto_II_rs485.sch]
2019-07-18 Proto II: RS485 isolated module board, order from JLCPCB
    [proto_II_rs485-B_Cu.gbr, proto_II_rs485-B_Mask.gbr, proto_II_rs485-B_Paste.gbr, proto_II_rs485-B_SilkS.gbr, proto_II_rs485-Edge_Cuts.gbr, proto_II_rs485-F_Cu.gbr, proto_II_rs485-F_Mask.gbr, proto_II_rs485-F_Paste.gbr]
2019-08-08 Capture real part information into the schematic
    [proto_II_buck_kicad.kicad_pcb, proto_II_buck_kicad.sch, proto_II_rs485.sch, proto_II_sensor_kicad.kicad_pcb, proto_II_sensor_kicad.sch]
2019-08-16 Rework sensor board: allow hand-soldering of sensor
    Additional sensor is used with easier footprint: Si70XX series
    [proto_II_rs485.sch, proto_II_sensor_kicad.kicad_pcb, proto_II_sensor_kicad.sch]
2019-08-17 Rework sensor board: gerber files
    [proto_II_sensor_kicad-B_Cu.gbl, proto_II_sensor_kicad-B_Mask.gbs, proto_II_sensor_kicad-B_Paste.gbp, proto_II_sensor_kicad-B_SilkS.gbo, proto_II_sensor_kicad-Board.gm1, proto_II_sensor_kicad-Bot.gbl, proto_II_sensor_kicad-BotMask.gbs, proto_II_sensor_kicad-BotSilk.gbo]
2019-08-17 Fix bug: spurious character led to infinite ModBus response
    + add script to read values and send them to TB
    [main.c, publish_bat_data.py]
2019-09-16 8mm sensor PCB
    [proto_II_sensor_small_kicad.csv, proto_II_sensor_small_kicad.kicad_pcb, proto_II_sensor_small_kicad.sch]
2019-09-18 Update instructions on flashing and using board for BAT tests
2019-09-30 Draft of assembled proto II
    [power.sch, proto_II_assembly.kicad_pcb, proto_II_assembly.sch, rs485.sch]
2019-10-01 Draft of assembled proto II: optimize BOM and put all logic components
    [power.sch, proto_II_assembly.sch, rs485.sch]
2019-10-02 Draft of assembled proto II: finalized BOM
    [Murata_CSTCEXX_3.2mmx1.3mm.stp, Tactile_Switch_5x5mm.STEP, power.sch, proto_II_assembly.sch, rs485.sch]
2019-10-07 proto II: finish draft routing
    [power.sch, proto_II_assembly.kicad_pcb, proto_II_assembly.sch, rs485.sch]
2019-10-07 proto II: add more pin designators to silkscreen
    [proto_II_assembly.kicad_pcb]
2019-10-18 proto I: migrate to Zephyr v2.0.0 and improve send script
    Add argparse to script. Move to SI7006 driver built in Zephyr.
2019-10-19 proto I: add MCU temperature reporting
2019-11-14 Better file management for git <-> kicad
2019-11-14 Better field naming for components
    [power.sch, proto_II_assembly.kicad_pcb, proto_II_assembly.sch, proto_II_buck_kicad.sch, proto_II_sensor_kicad.kicad_pcb, proto_II_sensor_kicad.sch, rs485.sch]
2019-11-15 Add boards variants and BOM processing script
    [power.sch, proto_II_assembly.sch, rs485.sch]
